stefaweb/DC-AC-Inverter-EGS/README.md

# Mini DC-AC-Inverter-EGS 1.0.2

PCB size: 90x44mm
