stefaweb/DC-AC-Inverter-EGS/DC-AC-Inverter-EGS-1.0.3/README.md

# Mini DC-AC-Inverter-EGS 1.0.3

PCB size: 90x44mm

DC-AC-Inverter-EGS-3D-NOEGS

DC-AC-Inverter-EGS-FRONT

DC-AC-Inverter-EGS-BACK

DC-AC-Inverter-EGS-diagram
