stefaweb/DC-AC-Inverter-EGS/DC-AC-Inverter-EGS-1.0.3/DC-AC-Inverter-EGS-3D-NOEGS.jpg

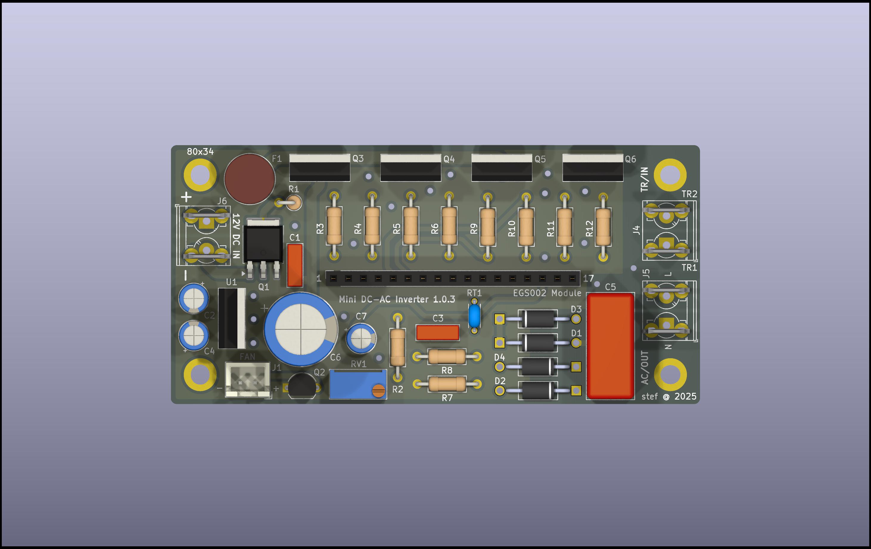
DC-AC-Inverter-EGS-1.0.3/DC-AC-Inverter-EGS-3D-NOEGS.jpg
