stefaweb/DC-AC-Inverter-EGS/DC-AC-Inverter-EGS-1.0.3/DC-AC-Inverter-EGS-diagram.pdf

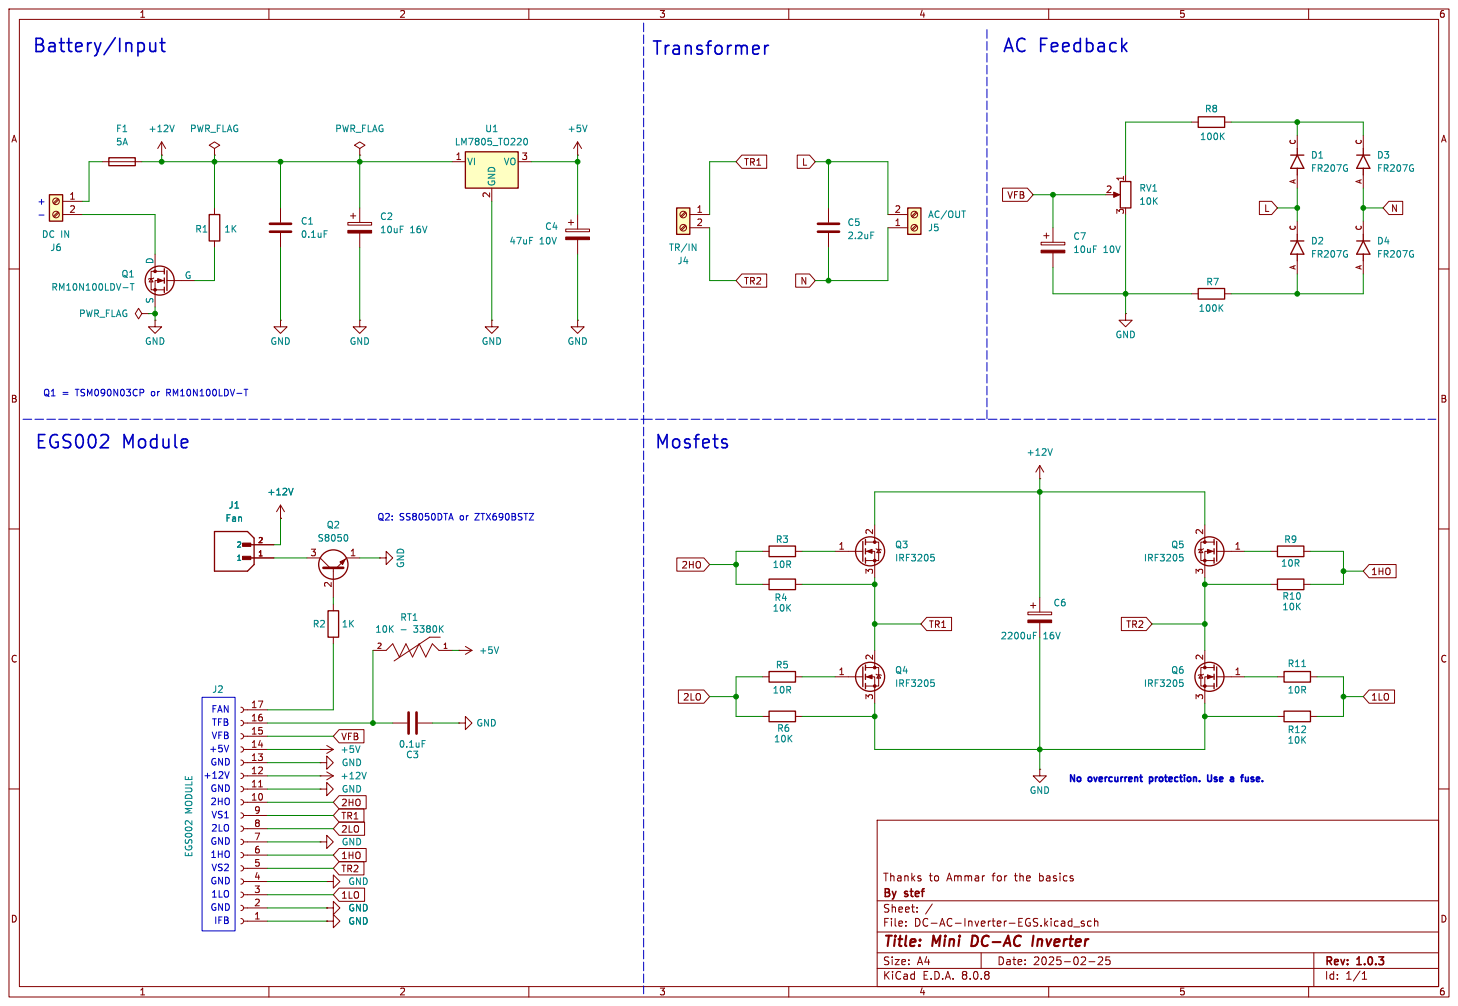
[picture p4: page 1]

IFB GND Q1 = TSM090N03CP or RM10N100LDV-T GND
VFB EGS002 Module
