stefaweb/DC-AC-Inverter-EGS/DC-AC-Inverter-EGS-1.0.3/DC-AC-Inverter-EGS.kicad_pcb

## KiCad design DC-AC-Inverter-EGS-1.0.3/DC-AC-Inverter-EGS.kicad_pcb (2025-02-25)

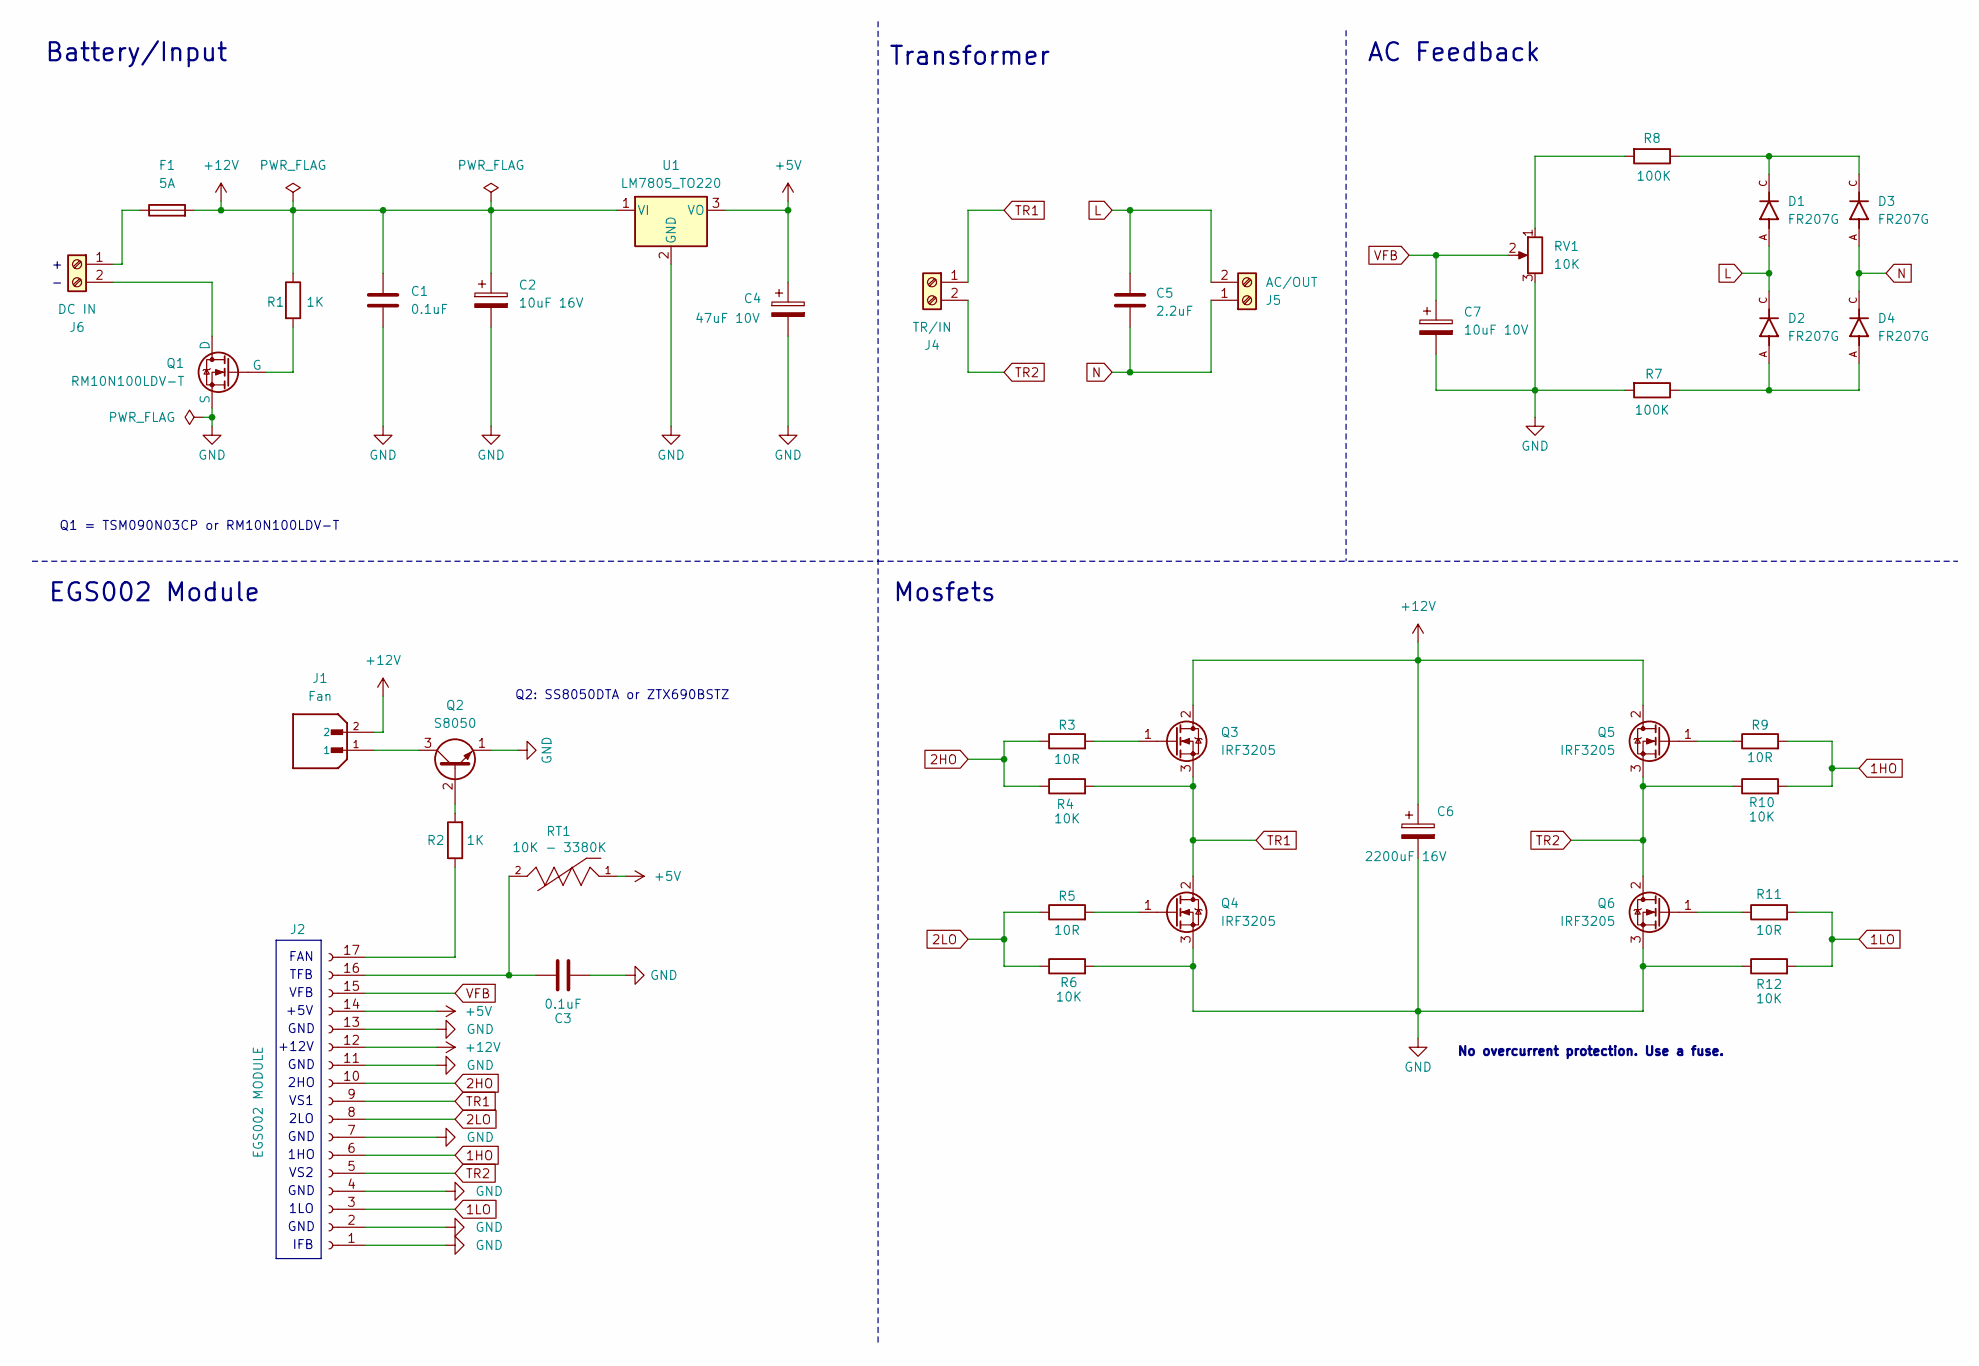
[picture p5: schematic DC-AC-Inverter-EGS.kicad_sch, Mini DC-AC Inverter]

Parts:
C1, C3: 0.1uF; C_Rect_L7.2mm_W2.5mm_P5.00mm_FKS2_FKP2_MKS2_MKP2
C2: 10uF 16V; CP_Radial_D5.0mm_P2.50mm
C4: 47uF 10V; CP_Radial_D5.0mm_P2.50mm
C5: 2.2uF; C_Rect_L18.0mm_W8.0mm_P15.00mm_FKS3_FKP3; Part# MKS4D042204F00KSSD; Mouser 505-MKS4D042204FKSSD
C6: 2200uF 16V; CP_Radial_D12.5mm_P5.00mm
C7: 10uF 10V; CP_Radial_D5.0mm_P2.50mm
D1, D2, D3: FR207G; PARTREV F2105; Mouser 821-FR207G
D4: FR207G; Part# FR207G; Mouser 821-FR207G
F1: 5A; Fuse_Littelfuse_372_D8.50mm
J1: Fan; JST_XH_B2B-XH-A_1x02_P2.50mm_Vertical; PARTREV N/A
J2: EGS002 MODULE; PinSocket_1x17_P2.54mm_Vertical
J4: TR/IN; TerminalBlock_Phoenix_PT-1,5-2-5.0-H_1x02_P5.00mm_Horizonta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
J5: AC/OUT; TerminalBlock_Phoenix_PT-1,5-2-5.0-H_1x02_P5.00mm_Horizonta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
J6: DC IN; TerminalBlock_Phoenix_PT-1,5-2-5.0-H_1x02_P5.00mm_Horizonta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
Q1: RM10N100LDV-T; TO-252-3_TabPin2; Part# RD3P03BBHTL1; Mouser 755-RD3P03BBHTL1
Q2: S8050; TO-92_Inline_Wide; Part# SS8050DTA; Mouser 512-SS8050DTA
Q3, Q4, Q5, Q6: IRF3205; TO-220-3_Vertical; Part# IRF3205PBF; Mouser 942-IRF3205PBF
R1: 1K; R_Axial_DIN0207_L6.3mm_D2.5mm_P2.54mm_Vertical
R2: 1K; R_Axial_DIN0207_L6.3mm_D2.5mm_P10.16mm_Horizontal
R3, R5, R9, R11: 10R; R_Axial_DIN0207_L6.3mm_D2.5mm_P10.16mm_Horizontal
R4, R6, R10, R12: 10K; R_Axial_DIN0207_L6.3mm_D2.5mm_P10.16mm_Horizontal
R7, R8: 100K; R_Axial_DIN0207_L6.3mm_D2.5mm_P10.16mm_Horizontal
RT1: 10K - 3380K; THERM_NXRT15WB333JA3A016; PARTREV N/A
RV1: 10K; Potentiometer_Bourns_3296W_Vertical
U1: LM7805_TO220; TO-220-3_Vertical; Part# LM7805CT/NOPB; Mouser 926-LM7805CT/NOPB

Connections:
1HO: J2.6, R9.2, R10.2
1LO: J2.3, R11.2, R12.2
2HO: J2.10, R3.1, R4.1
2LO: J2.8, R5.1, R6.1
+5V: C4.1, J2.14, RT1.1, U1.3 (VO)
+12V: C1.1, C2.1, C6.1, F1.2, J1.2, J2.12, Q3.2 (D), Q5.2 (D), R1.1, U1.1 (VI)
GND: C1.2, C2.2, C3.2, C4.2, C6.2, C7.2, J2.1, J2.2, J2.4, J2.7, J2.11, J2.13, Q1.3 (S), Q2.1 (E), Q4.3 (S), Q6.3 (S), R6.2, R7.2, R12.1, RV1.3, U1.2 (GND)
L: C5.1, D1.A, D2.C, J5.2
N: C5.2, D3.A, D4.C, J5.1
unnamed: D1.C, D3.C, R8.1
unnamed: D2.A, D4.A, R7.1
unnamed: C3.1, J2.16, RT1.2
unnamed: J2.17, R2.1
unnamed: F1.1, J6.1
unnamed: J6.2, Q1.1 (D)
unnamed: Q1.2 (G), R1.2
unnamed: Q2.2 (B), R2.2
unnamed: J1.1, Q2.3 (C)
unnamed: Q3.1 (G), R3.2
unnamed: Q4.1 (G), R5.2
unnamed: Q5.1 (G), R9.1
unnamed: Q6.1 (G), R11.1
unnamed: R8.2, RV1.1
TR1: J2.9, J4.1, Q3.3 (S), Q4.2 (D), R4.2
TR2: J2.5, J4.2, Q5.3 (S), Q6.2 (D), R10.1
VFB: C7.1, J2.15, RV1.2

Notes on the sheet:
VFB
VS2
GND
No overcurrent protection. Use a fuse.
2HO
Battery/Input
Q2: SS8050DTA or ZTX690BSTZ
Q1 = TSM090N03CP or RM10N100LDV-T
EGS002 Module
1HO
1LO
TFB
IFB
VS1
Transformer
AC Feedback
2LO
+5V
FAN
+12V
Mosfets

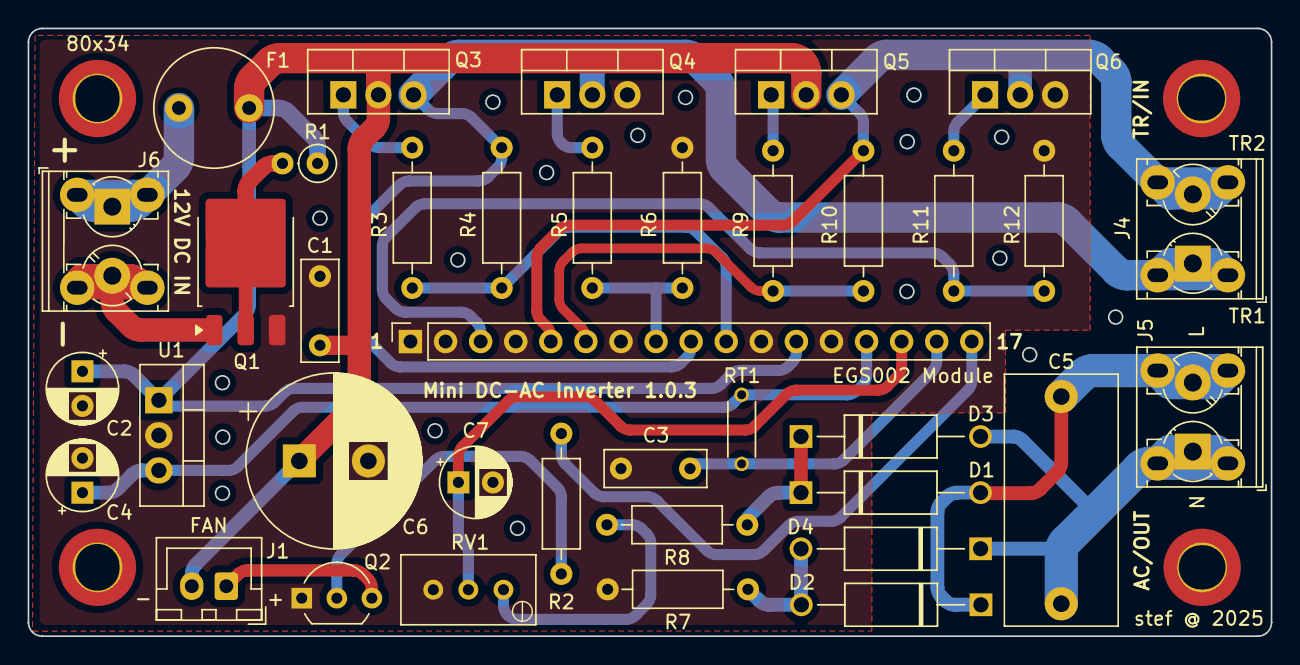
[picture p6: board DC-AC-Inverter-EGS.kicad_pcb from above]

Board: 2 copper layers, 90.0 x 44.0 mm, 42 parts (0 on the bottom side), 26 nets.

Other parts of the board:
H1, H1#2, H1#3, H1#4: MountingHole; MountingHole_3.2mm_M3_DIN965_Pad_TopBottom
