stefaweb/DC-AC-Inverter-EGS/(commit log)

2025-01-21 First upload
    [DC-AC-Inverter-EGS.kicad_pcb, DC-AC-Inverter-EGS.kicad_sch]
2025-01-24 Update folder
    [DC-AC-Inverter-EGS.kicad_pcb, DC-AC-Inverter-EGS.kicad_sch]
2025-02-25 Upload DC-AC-Inverter-EGS-1.0.3
    [DC-AC-Inverter-EGS.kicad_pcb, DC-AC-Inverter-EGS.kicad_sch]
